ghiggins3019/eclipse40/eclipse40v2.kicad_pcb

## KiCad design eclipse40v2.kicad_pcb (2025-10-31)

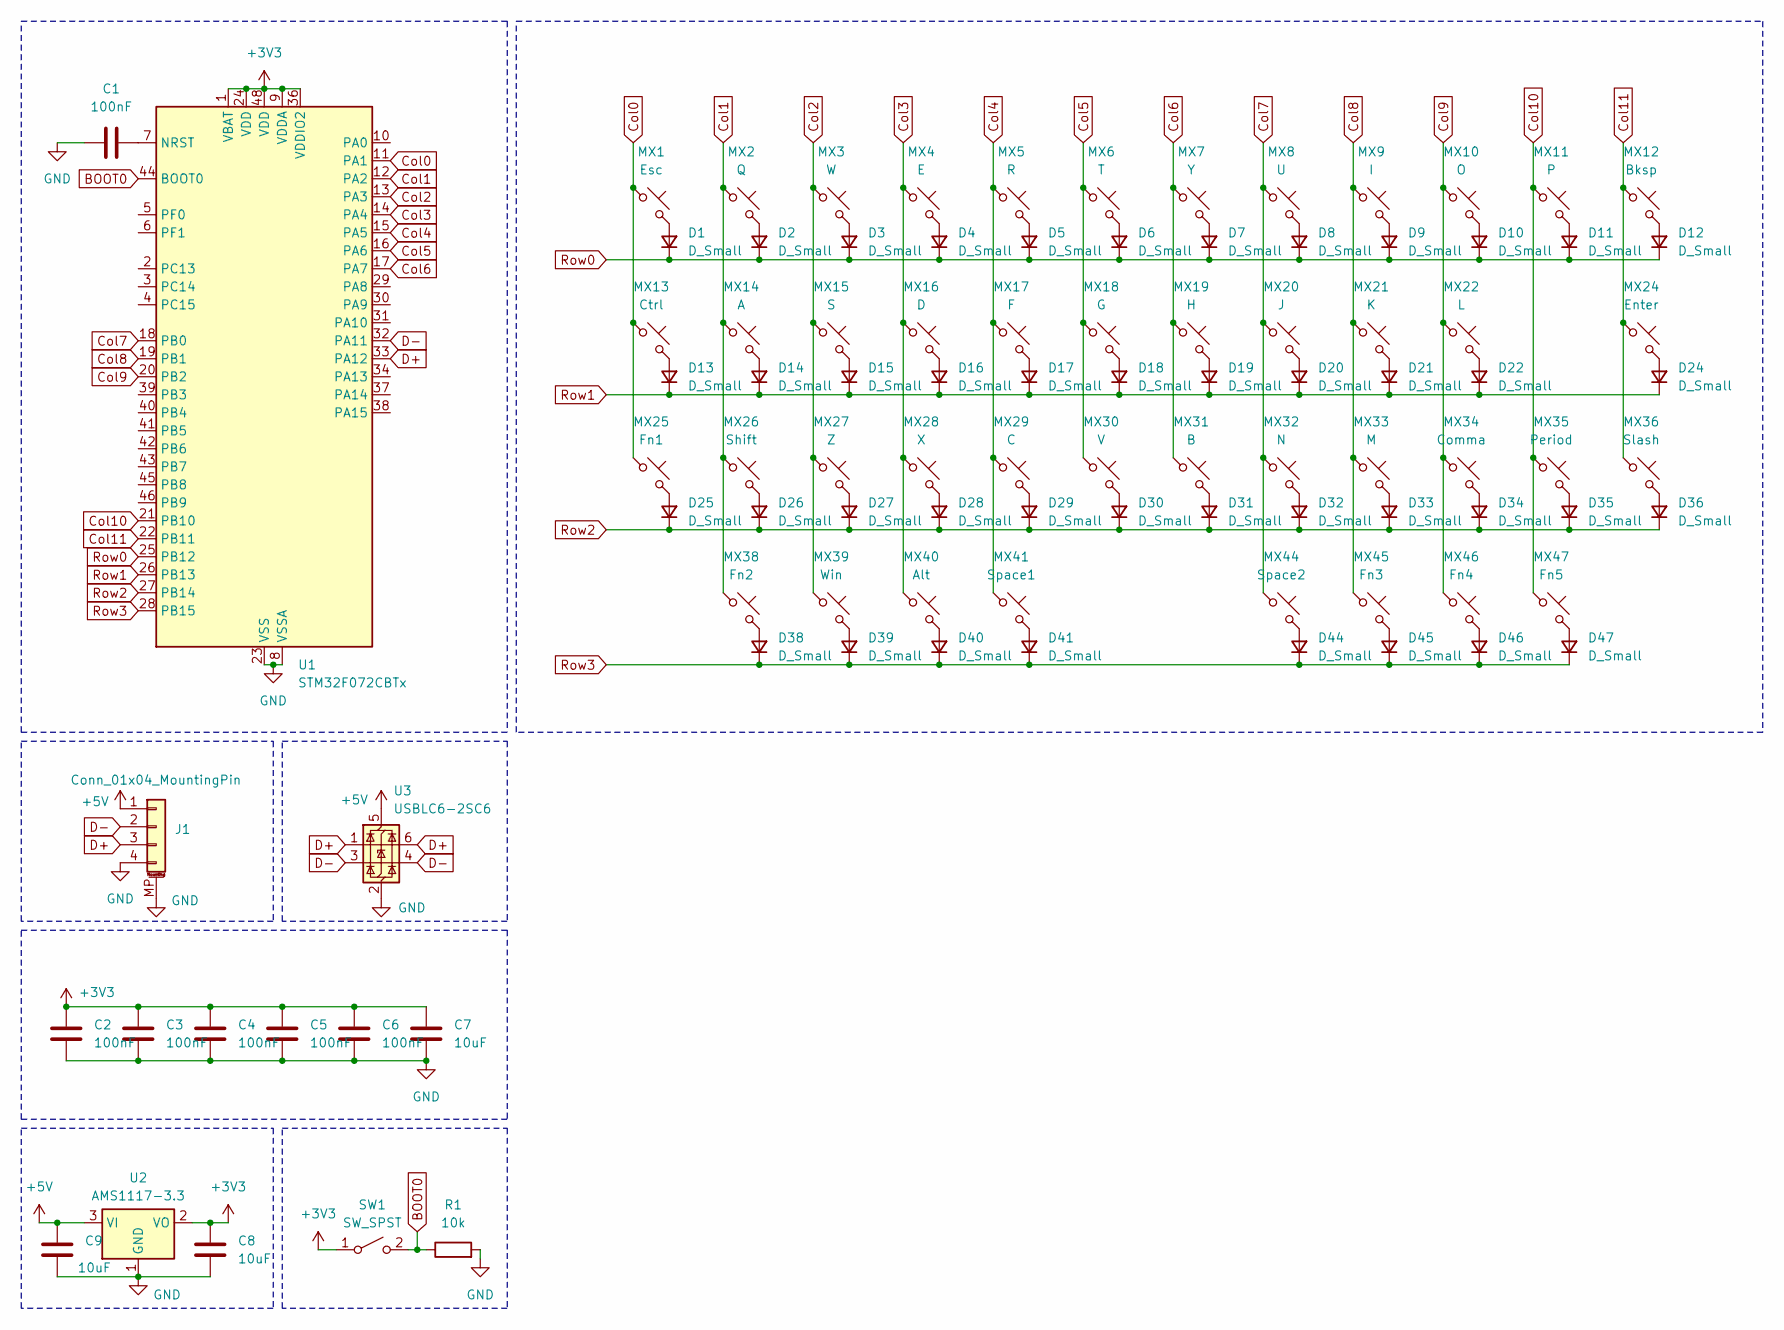
[picture p1: schematic eclipse40v2.kicad_sch]

Parts:
C1, C2, C3, C4, C5, C6: 100nF; C_0805_2012Metric_Pad1.18x1.45mm_HandSolder
C7, C8, C9: 10uF; C_0805_2012Metric_Pad1.18x1.45mm_HandSolder
D1, D2, D3, D4, D5, D6, D7, D8, D9, D10, D11, D12, D13, D14, D15, D16, D17, D18, D19, D20, D21, D22, D24, D25, D26, D27, D28, D29, D30, D31, D32, D33, D34, D35, D36, D38, D39, D40, D41, D44, D45, D46, D47: D_Small; D_0805_2012Metric_Pad1.15x1.40mm_HandSolder
J1: Conn_01x04_MountingPin; Molex_Pico-EZmate_78171-0004_1x04-1MP_P1.20mm_Vertical
MX1: Esc; SW_MX_HS_CPG151101S11_1.5u
MX2: Q; SW_MX_HS_CPG151101S11_1u
MX3: W; SW_MX_HS_CPG151101S11_1u
MX4: E; SW_MX_HS_CPG151101S11_1u
MX5: R; SW_MX_HS_CPG151101S11_1u
MX6: T; SW_MX_HS_CPG151101S11_1u
MX7: Y; SW_MX_HS_CPG151101S11_1u
MX8: U; SW_MX_HS_CPG151101S11_1u
MX9: I; SW_MX_HS_CPG151101S11_1u
MX10: O; SW_MX_HS_CPG151101S11_1u
MX11: P; SW_MX_HS_CPG151101S11_1u
MX12: Bksp; SW_MX_HS_CPG151101S11_1.5u
MX13: Ctrl; SW_MX_HS_CPG151101S11_1.75u
MX14: A; SW_MX_HS_CPG151101S11_1u
MX15: S; SW_MX_HS_CPG151101S11_1u
MX16: D; SW_MX_HS_CPG151101S11_1u
MX17: F; SW_MX_HS_CPG151101S11_1u
MX18: G; SW_MX_HS_CPG151101S11_1u
MX19: H; SW_MX_HS_CPG151101S11_1u
MX20: J; SW_MX_HS_CPG151101S11_1u
MX21: K; SW_MX_HS_CPG151101S11_1u
MX22: L; SW_MX_HS_CPG151101S11_1u
MX24: Enter; SW_MX_HS_CPG151101S11_1u
MX25: Fn1; SW_MX_HS_CPG151101S11_1u
MX26: Shift; SW_MX_HS_CPG151101S11_1.25u
MX27: Z; SW_MX_HS_CPG151101S11_1u
MX28: X; SW_MX_HS_CPG151101S11_1u
MX29: C; SW_MX_HS_CPG151101S11_1u
MX30: V; SW_MX_HS_CPG151101S11_1u
MX31: B; SW_MX_HS_CPG151101S11_1u
MX32: N; SW_MX_HS_CPG151101S11_1u
MX33: M; SW_MX_HS_CPG151101S11_1u
MX34: Comma; SW_MX_HS_CPG151101S11_1u
MX35: Period; SW_MX_HS_CPG151101S11_1u
MX36: Slash; SW_MX_HS_CPG151101S11_1.75u
MX38: Fn2; SW_MX_HS_CPG151101S11_1u
MX39: Win; SW_MX_HS_CPG151101S11_1u
MX40: Alt; SW_MX_HS_CPG151101S11_1u
MX41: Space1; SW_MX_HS_CPG151101S11_1u
MX44: Space2; SW_MX_HS_CPG151101S11_1u
MX45: Fn3; SW_MX_HS_CPG151101S11_1u
MX46: Fn4; SW_MX_HS_CPG151101S11_1u
MX47: Fn5; SW_MX_HS_CPG151101S11_1u
R1: 10k; C_0805_2012Metric_Pad1.18x1.45mm_HandSolder
SW1: SW_SPST; SW_SPST_SKQG_WithStem
U1: STM32F072CBTx; LQFP-48_7x7mm_P0.5mm
U2: AMS1117-3.3; SOT-223-3_TabPin2
U3: USBLC6-2SC6; SOT-23-6

Connections:
+3V3: C2.2, C3.2, C4.2, C5.2, C6.2, C7.2, C8.1, SW1.1 (A), U1.1 (VBAT), U1.9 (VDDA), U1.24 (VDD), U1.36 (VDDIO2), U1.48 (VDD), U2.2 (VO)
+5V: C9.1, J1.1, U2.3 (VI), U3.5 (VBUS)
BOOT0: R1.1, SW1.2 (B), U1.44 (BOOT0)
Col0: MX1.1, MX13.1, MX25.1, U1.11 (PA1)
Col1: MX2.1, MX14.1, MX26.1, MX38.1, U1.12 (PA2)
Col2: MX3.1, MX15.1, MX27.1, MX39.1, U1.13 (PA3)
Col3: MX4.1, MX16.1, MX28.1, MX40.1, U1.14 (PA4)
Col4: MX5.1, MX17.1, MX29.1, MX41.1, U1.15 (PA5)
Col5: MX6.1, MX18.1, MX30.1, U1.16 (PA6)
Col6: MX7.1, MX19.1, MX31.1, U1.17 (PA7)
Col7: MX8.1, MX20.1, MX32.1, MX44.1, U1.18 (PB0)
Col8: MX9.1, MX21.1, MX33.1, MX45.1, U1.19 (PB1)
Col9: MX10.1, MX22.1, MX34.1, MX46.1, U1.20 (PB2)
Col10: MX11.1, MX35.1, MX47.1, U1.21 (PB10)
Col11: MX12.1, MX24.1, MX36.1, U1.22 (PB11)
D+: J1.3, U1.33 (PA12), U3.1 (I/O1), U3.6 (I/O1)
D-: J1.2, U1.32 (PA11), U3.3 (I/O2), U3.4 (I/O2)
GND: C1.1, C2.1, C3.1, C4.1, C5.1, C6.1, C7.1, C8.2, C9.2, J1.4, J1.MP (MountPin), R1.2, U1.8 (VSSA), U1.23 (VSS), U1.35 (VSS), U1.47 (VSS), U2.1 (GND), U3.2 (GND)
unnamed: D1.2 (A), MX1.2
unnamed: D2.2 (A), MX2.2
unnamed: D3.2 (A), MX3.2
unnamed: D4.2 (A), MX4.2
unnamed: D5.2 (A), MX5.2
unnamed: D6.2 (A), MX6.2
unnamed: D7.2 (A), MX7.2
unnamed: D8.2 (A), MX8.2
unnamed: D9.2 (A), MX9.2
unnamed: D10.2 (A), MX10.2
unnamed: D11.2 (A), MX11.2
unnamed: D12.2 (A), MX12.2
unnamed: D13.2 (A), MX13.2
unnamed: D14.2 (A), MX14.2
unnamed: D15.2 (A), MX15.2
unnamed: D16.2 (A), MX16.2
unnamed: D17.2 (A), MX17.2
unnamed: D18.2 (A), MX18.2
unnamed: D19.2 (A), MX19.2
unnamed: D20.2 (A), MX20.2
unnamed: D21.2 (A), MX21.2
unnamed: D22.2 (A), MX22.2
unnamed: D24.2 (A), MX24.2
unnamed: D25.2 (A), MX25.2
unnamed: D26.2 (A), MX26.2
unnamed: D27.2 (A), MX27.2
unnamed: D28.2 (A), MX28.2
unnamed: D29.2 (A), MX29.2
unnamed: D30.2 (A), MX30.2
unnamed: D31.2 (A), MX31.2
unnamed: D32.2 (A), MX32.2
unnamed: D33.2 (A), MX33.2
unnamed: D34.2 (A), MX34.2
unnamed: D35.2 (A), MX35.2
unnamed: D36.2 (A), MX36.2
unnamed: D38.2 (A), MX38.2
unnamed: D39.2 (A), MX39.2
unnamed: D40.2 (A), MX40.2
unnamed: D41.2 (A), MX41.2
unnamed: D44.2 (A), MX44.2
unnamed: D45.2 (A), MX45.2
unnamed: D46.2 (A), MX46.2
unnamed: D47.2 (A), MX47.2
unnamed: C1.2, U1.7 (NRST)
Row0: D1.1 (K), D2.1 (K), D3.1 (K), D4.1 (K), D5.1 (K), D6.1 (K), D7.1 (K), D8.1 (K), D9.1 (K), D10.1 (K), D11.1 (K), D12.1 (K), U1.25 (PB12)
Row1: D13.1 (K), D14.1 (K), D15.1 (K), D16.1 (K), D17.1 (K), D18.1 (K), D19.1 (K), D20.1 (K), D21.1 (K), D22.1 (K), D24.1 (K), U1.26 (PB13)
Row2: D25.1 (K), D26.1 (K), D27.1 (K), D28.1 (K), D29.1 (K), D30.1 (K), D31.1 (K), D32.1 (K), D33.1 (K), D34.1 (K), D35.1 (K), D36.1 (K), U1.27 (PB14)
Row3: D38.1 (K), D39.1 (K), D40.1 (K), D41.1 (K), D44.1 (K), D45.1 (K), D46.1 (K), D47.1 (K), U1.28 (PB15)

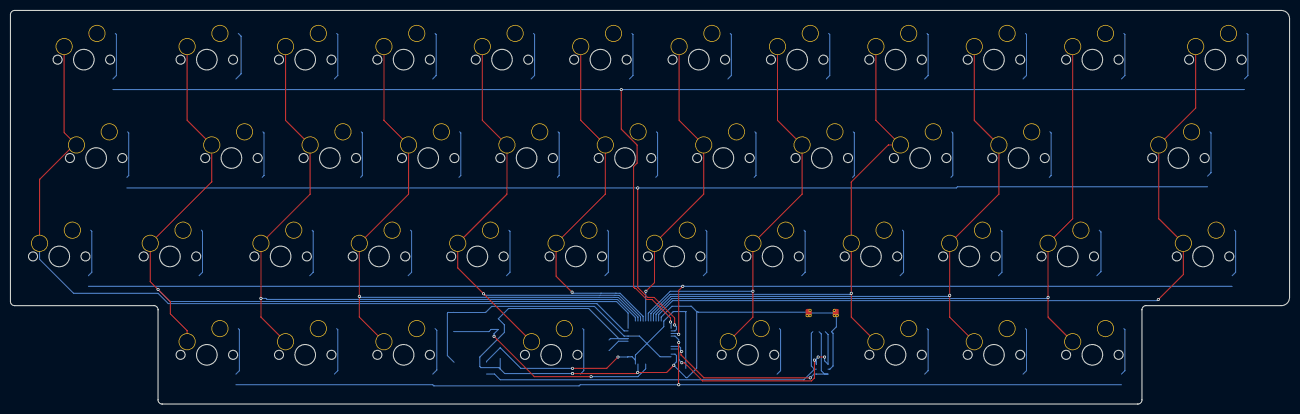
[picture p2: board eclipse40v2.kicad_pcb from above]

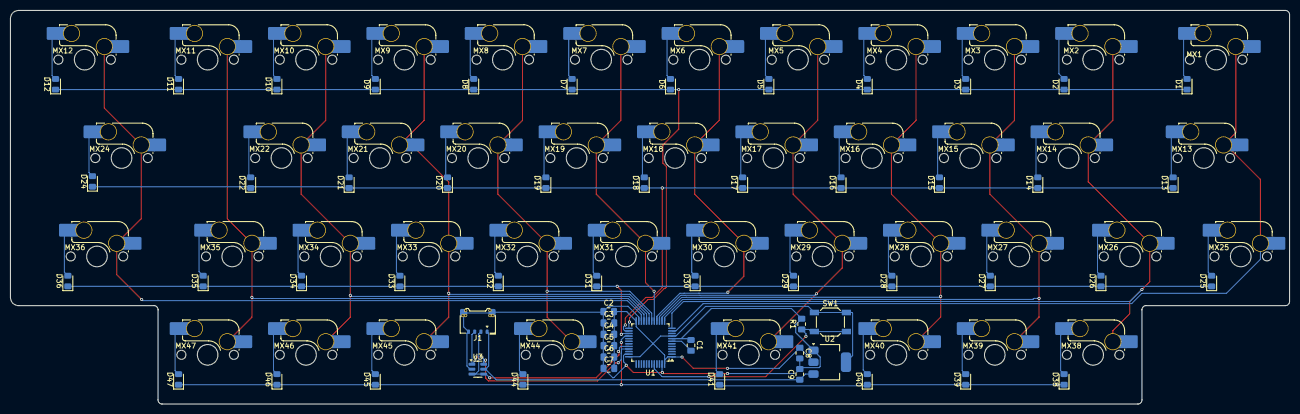
[picture p3: board eclipse40v2.kicad_pcb from below]

Board: 2 copper layers, 247.7 x 76.2 mm, 101 parts (101 on the bottom side), 66 nets.
